MathiasECE/H2-Vision/(commit log)

2026-10-29 feat: Initial commit H2-Vision — ESP32-S3 Dual-Core FreeRTOS firmware, Web dashboard, architecture docs
    [BOM_Composants_H2_Vision.csv, BOM_Composants_H2_Vision.xlsx, Composants_H2_Vision.xlsx]
2026-10-29 refactor: Clean repository structure, remove simulations, organize docs and dashboard
    [BOM_Composants_H2_Vision.csv, BOM_Composants_H2_Vision.xlsx, Composants_H2_Vision.xlsx]
2026-10-29 docs: Remove duplicate HTML and redundant component lists, keep only clean architecture and BOM.csv
    [BOM_Composants_H2_Vision.xlsx, Composants_H2_Vision.xlsx]
2026-11-05 refactor: Move NTC thermistor pin to GPIO 6 (ADC1_CH5)
2026-11-05 feat: Add fuel cell polarization curve & driver throttle simulator with hardware PWM generator
2026-11-05 feat: Add Simulation project for ESP32 #2 with multi-signal hardware generator
2026-11-05 feat(simulation): add dynamic ESP32-S3 and NodeMCU-32S pin mapping for bench test
2026-11-05 config(platformio): set esp32-s3-devkitc-1 as default environment
2026-11-11 fix(simulation): move PIN_HALL_OUT from GPIO 21 to GPIO 16 (same row as GPIO 4-18)
    [main.cpp]
2026-11-12 fix(simulation): separate LEDC timers to prevent Channel 1 from crushing Channel 0 duty cycle
    [main.cpp]
2026-11-12 feat(telemetry): add HIL bench scaling multipliers for realistic Horizon H-30 fuel cell power curves
2026-11-12 feat(telemetry): update HIL bench multipliers for IN+ tied to GPIO 18 (8.1V, 4.2A, 33W peak)
