MathiasECE/H2-Vision/(notices)

Notices in the files:
README.md:
License: MIT
